marangisto/ProtoCV/pcb.png

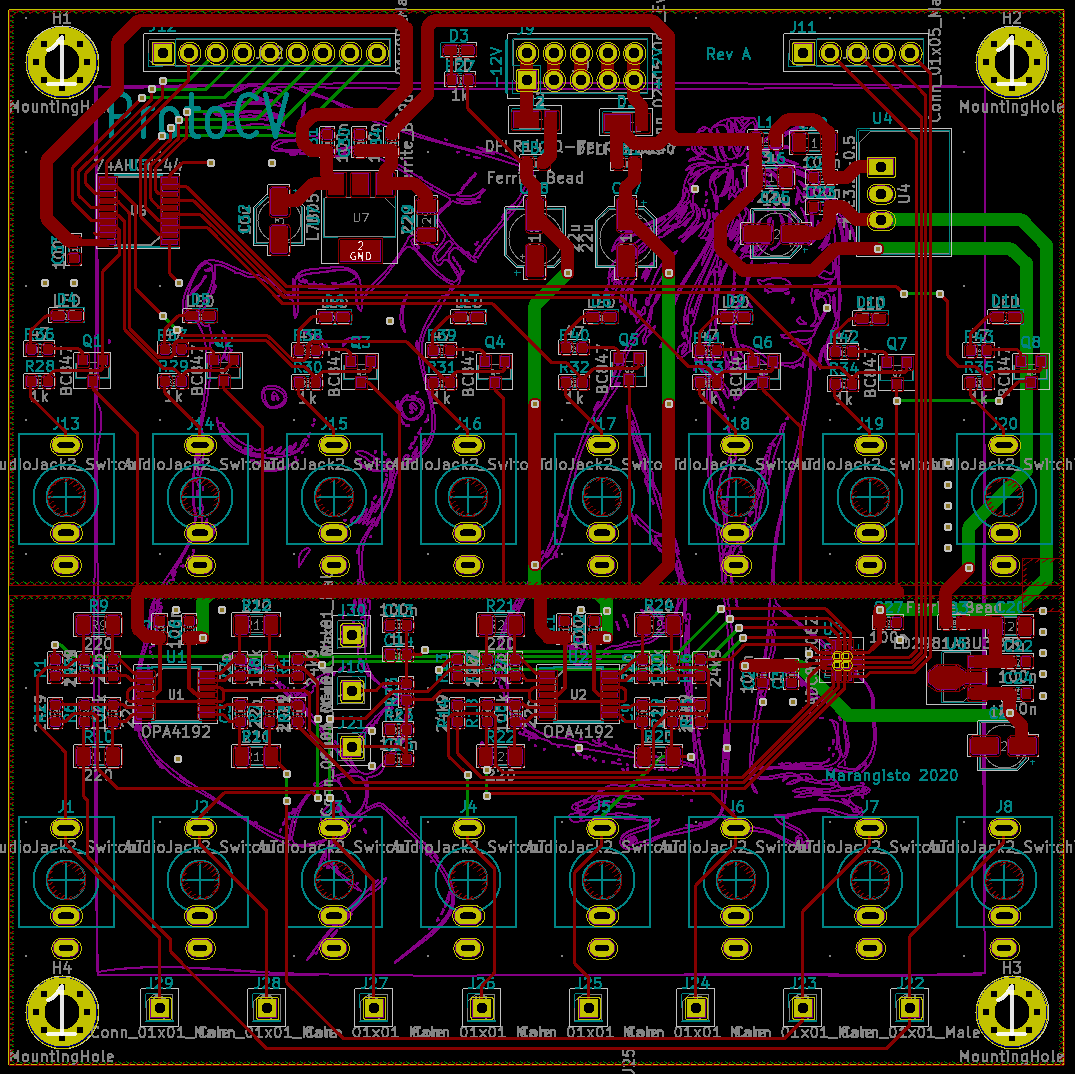
pcb.png
