marangisto/ProtoCV/render-01.png

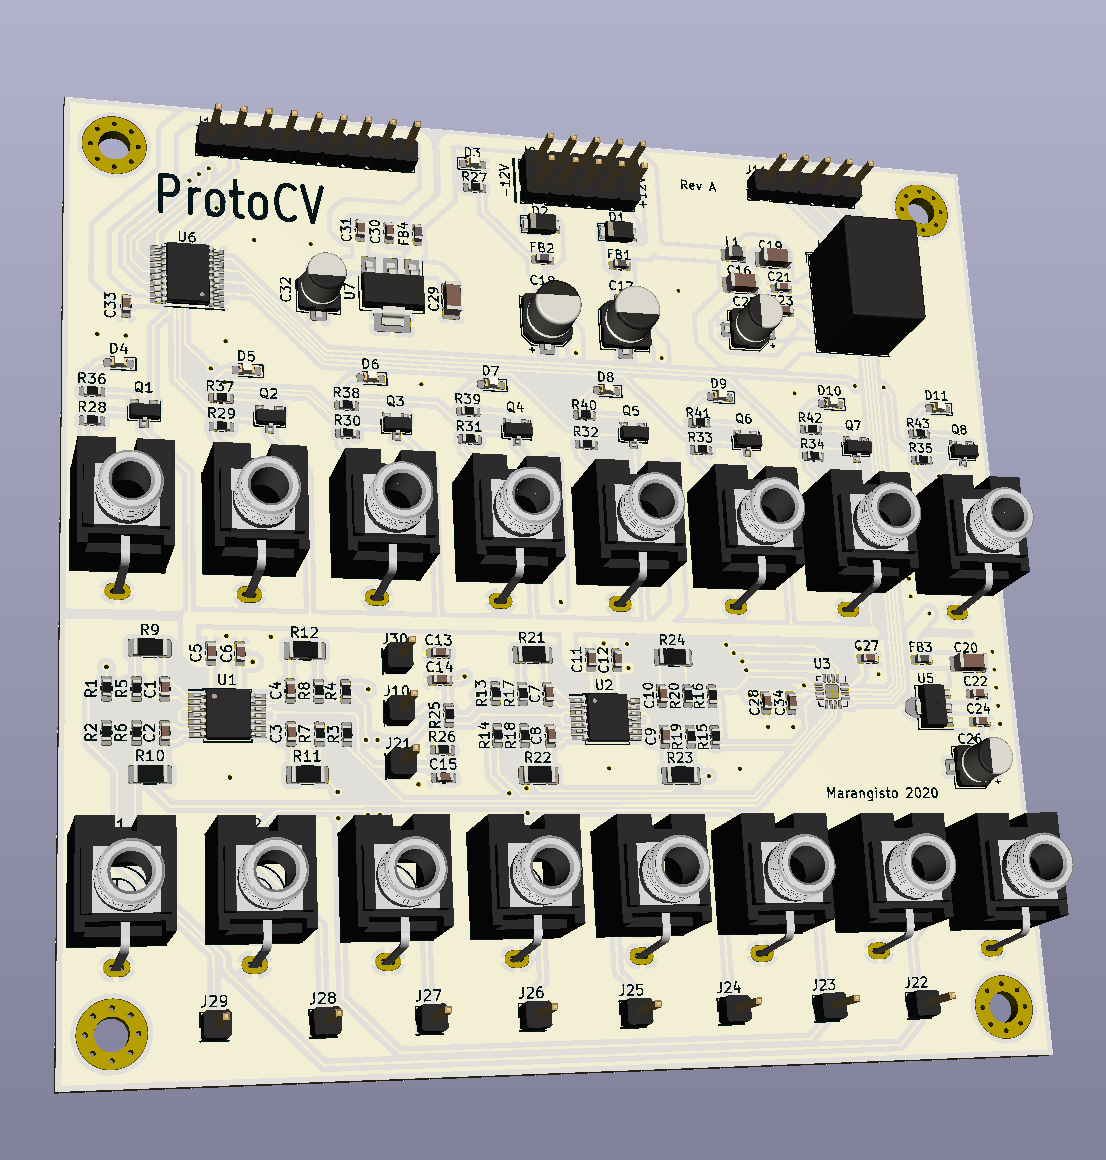
render-01.png
