marangisto/ProtoCV/render-02.png

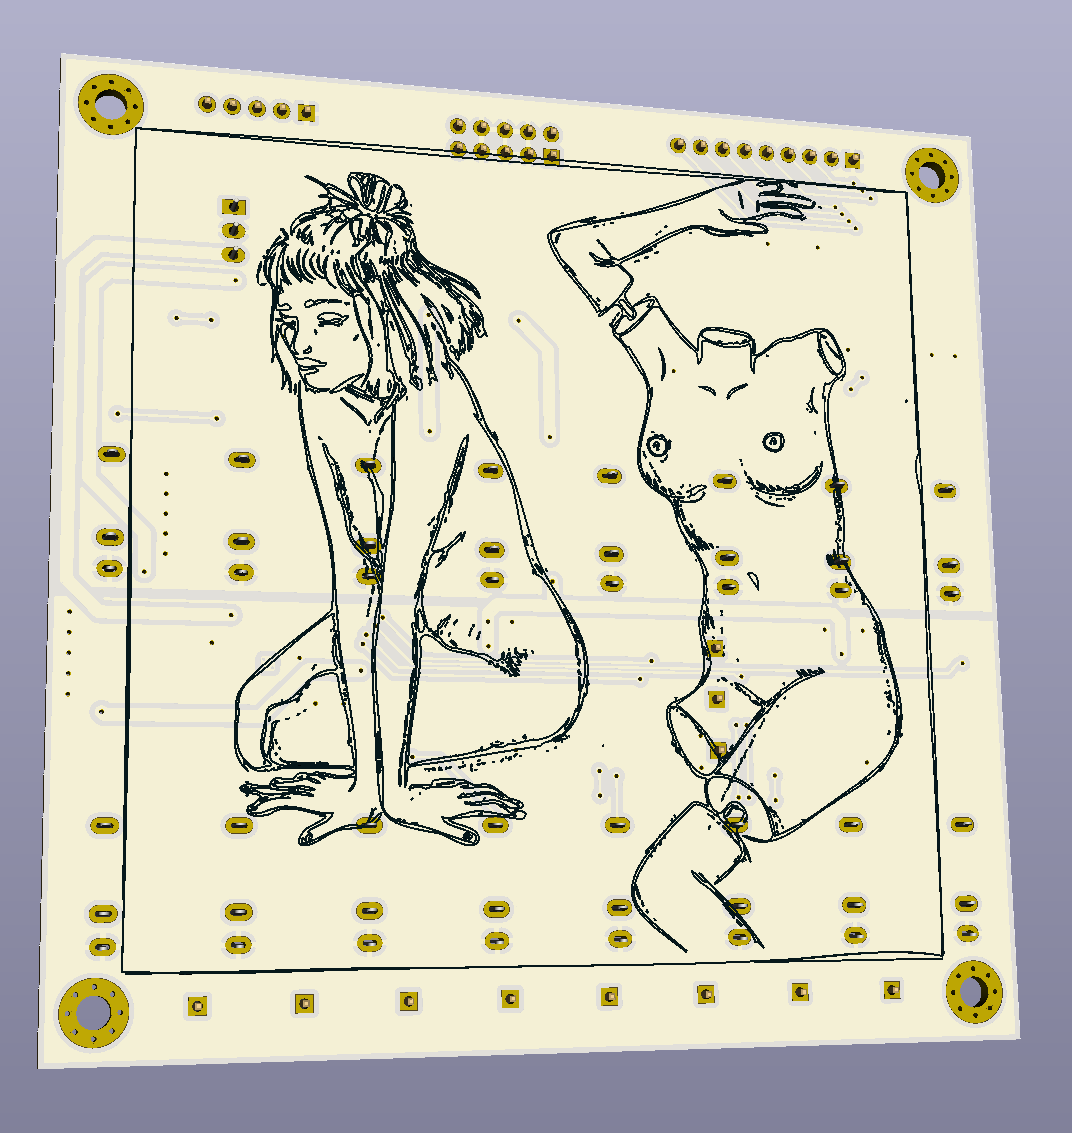
render-02.png
