marangisto/ProtoCV/schematic.png

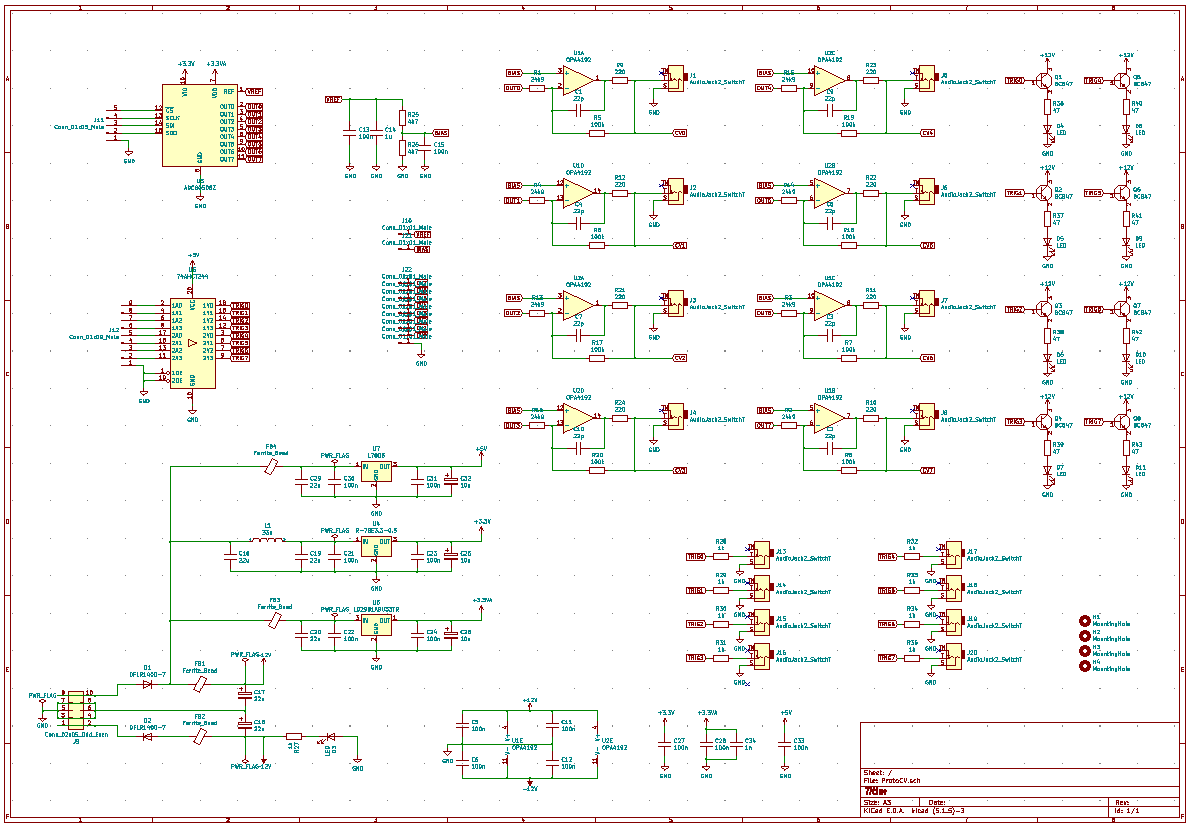
schematic.png
