marangisto/ProtoCV/ProtoCV.pdf

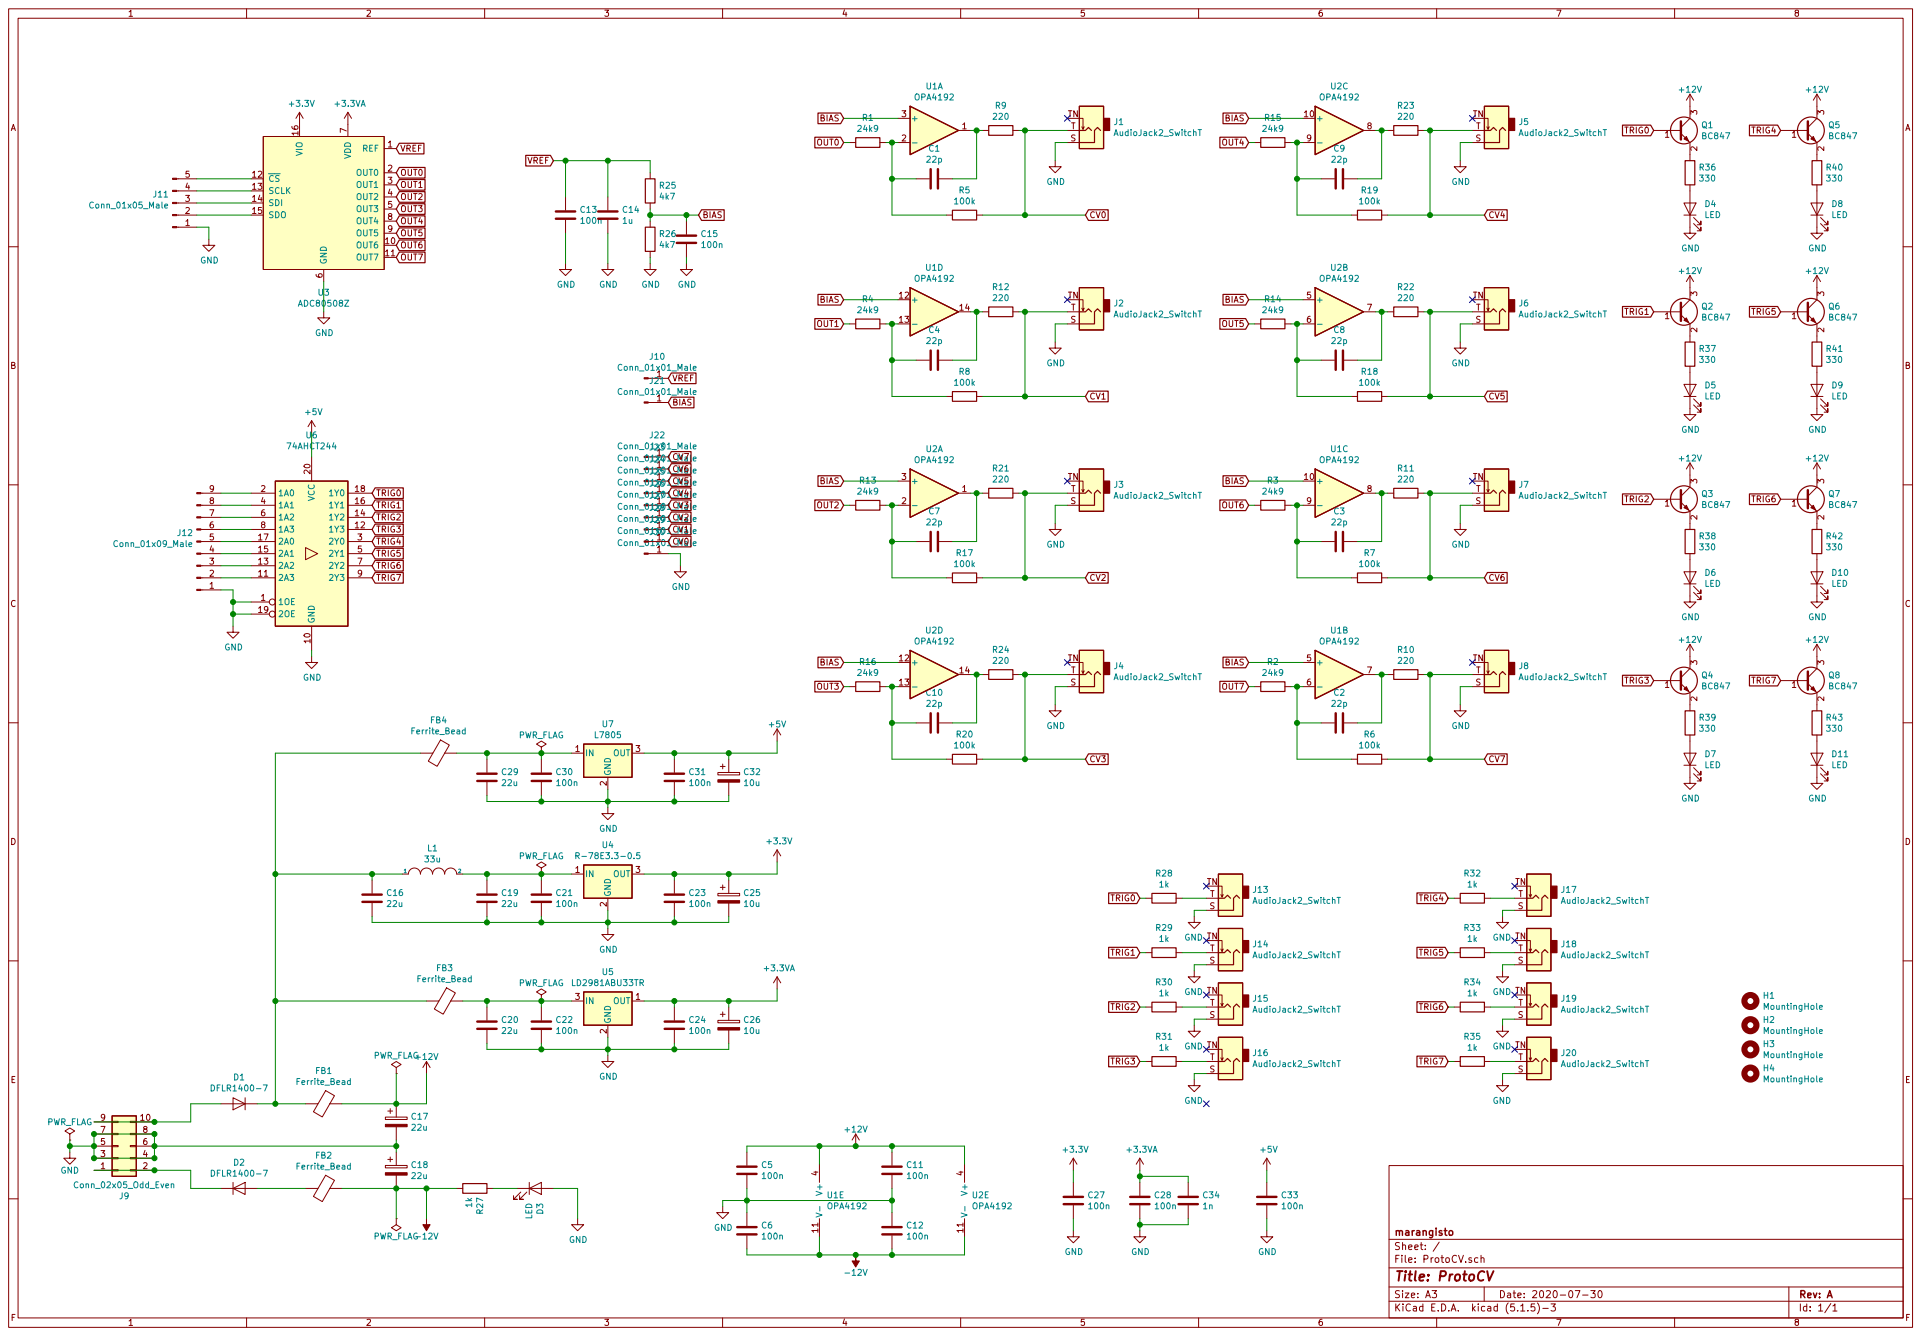
[picture p5: page 1]

5 3 | 6

File: ProtoCV.sch Sheet: / marangisto
