marangisto/ProtoCV/ProtoCV.kicad_pcb

## KiCad design ProtoCV.kicad_pcb (2020-12-03)

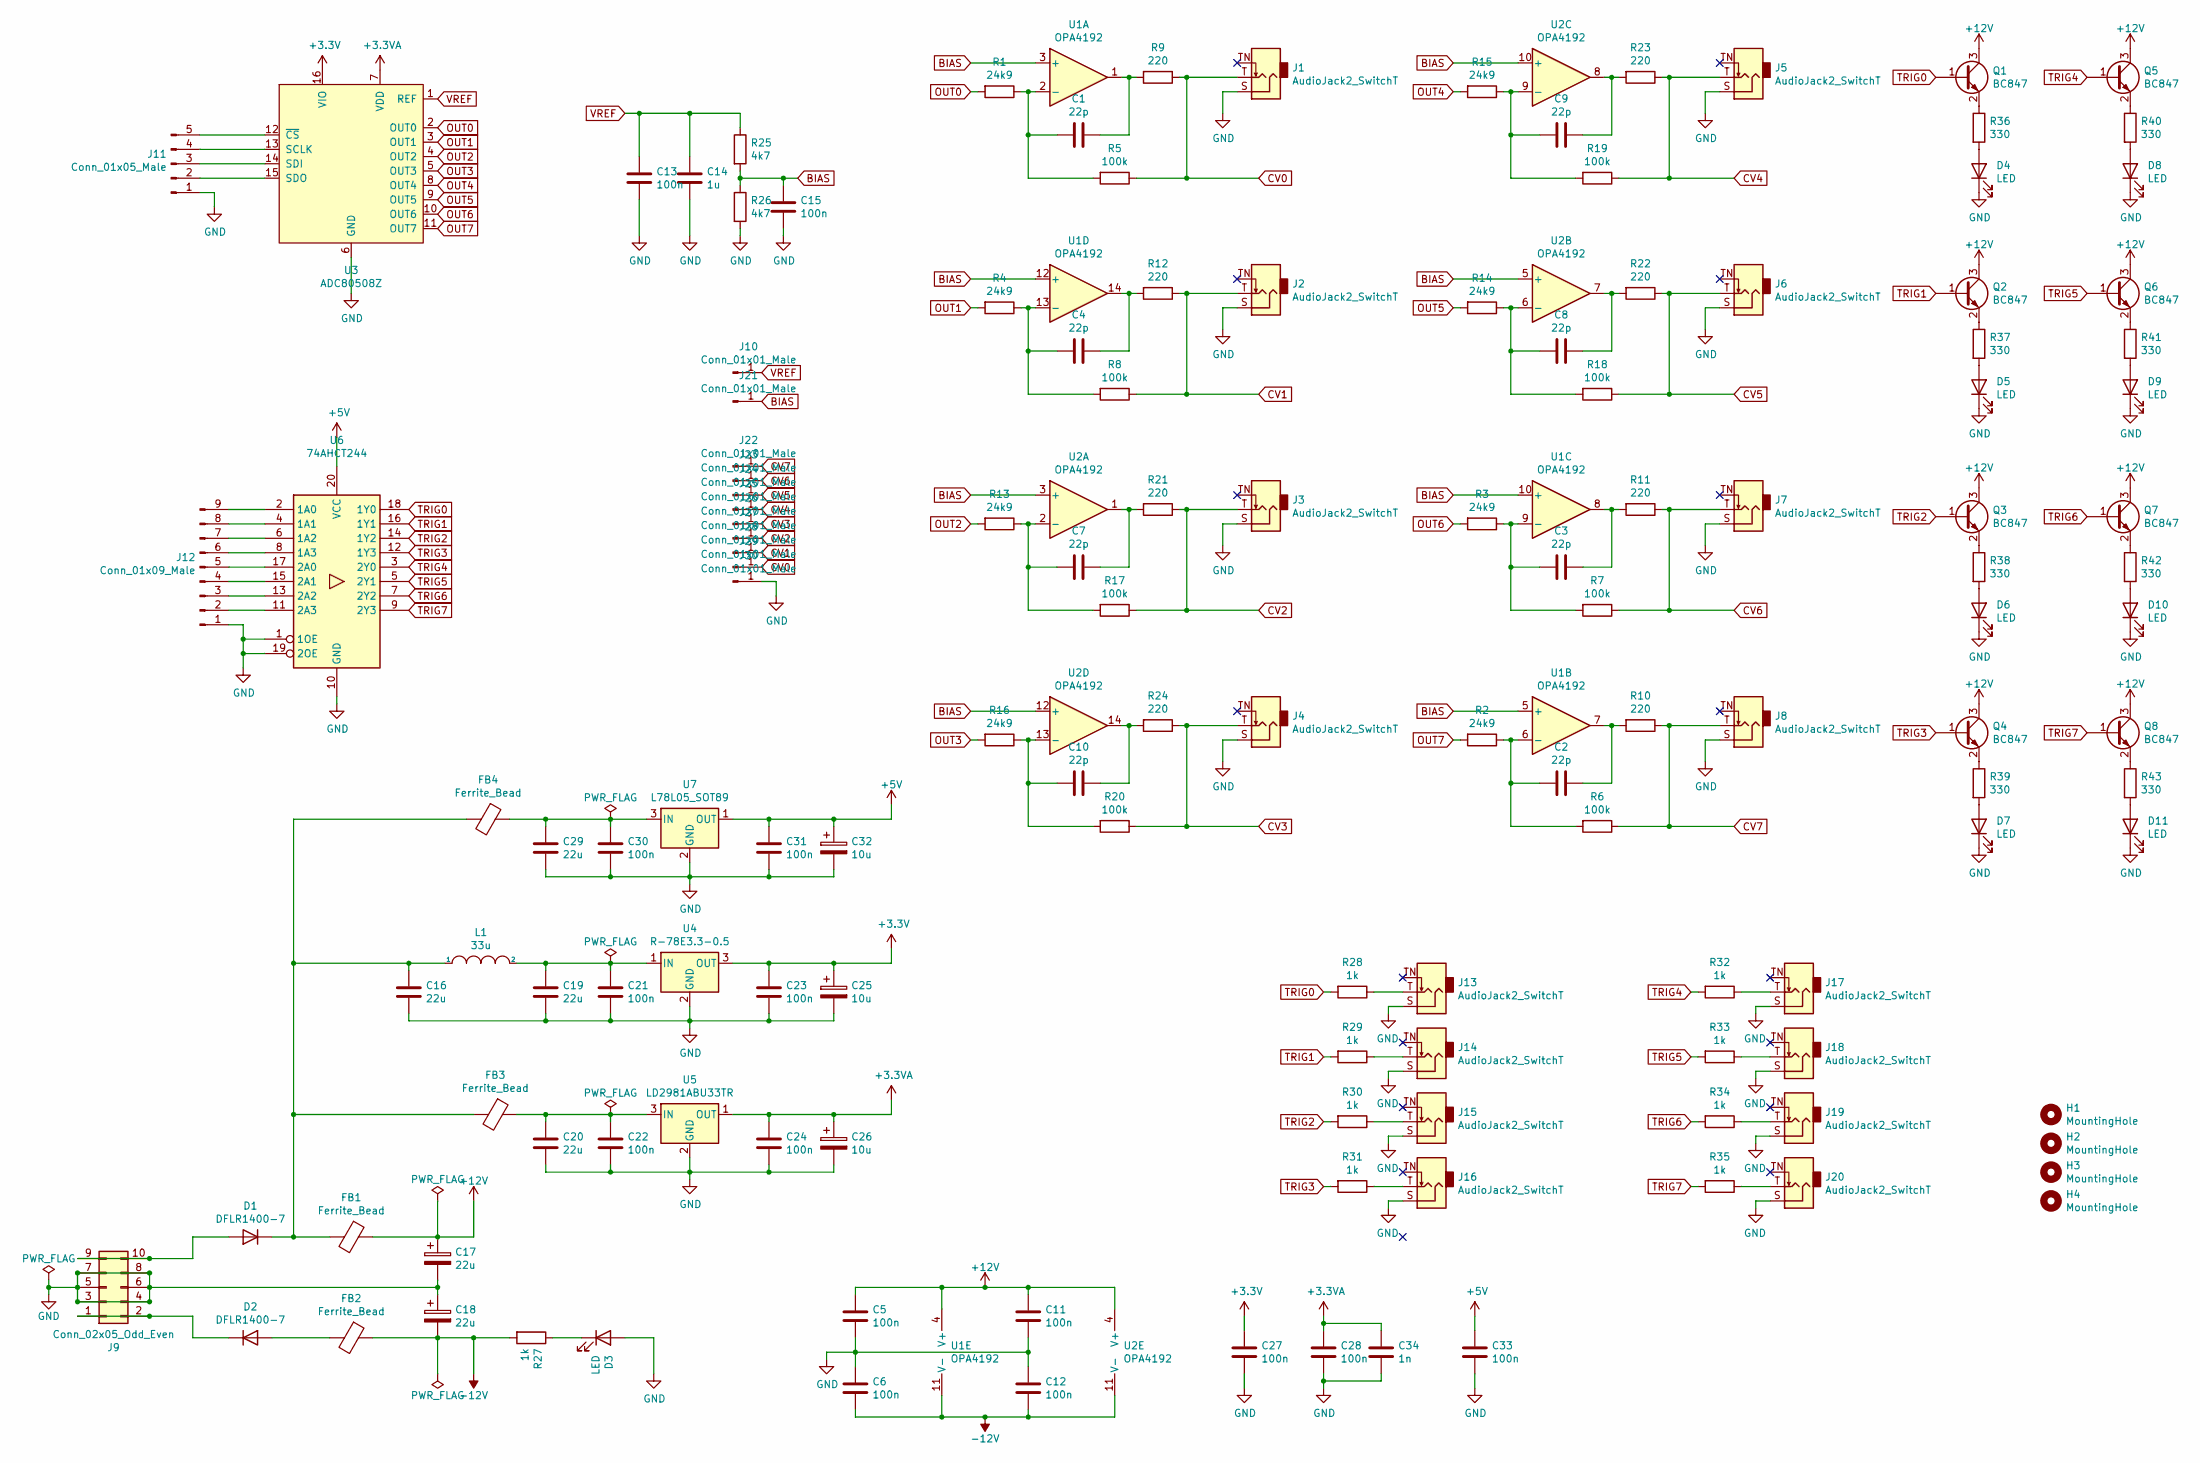
[picture p6: schematic ProtoCV.sch]

Parts:
C1, C2, C3, C4, C7, C8, C9, C10: 22p; C_0603_1608Metric
C5, C6, C11, C12, C13, C15, C21, C22, C23, C24, C27, C28, C30, C31, C33: 100n; C_0603_1608Metric
C14: 1u; C_0603_1608Metric
C16, C19, C20, C29: 22u; C_1206_3216Metric
C17, C18: 22u; CP_Elec_5x5.4
C25, C26, C32: 10u; CP_Elec_4x5.8
C34: 1n; C_0603_1608Metric
D1, D2: DFLR1400-7; D_PowerDI-123
D3, D4, D5, D6, D7, D8, D9, D10, D11: LED; LED_0603_1608Metric_Castellated
FB1, FB2, FB3, FB4: Ferrite_Bead; L_0603_1608Metric
H1, H2, H3, H4: MountingHole; MountingHole_3.2mm_M3_Pad_Via
J1, J2, J3, J4, J5, J6, J7, J8, J13, J14, J15, J16, J17, J18, J19, J20: AudioJack2_SwitchT; PJ398SM
J9: Conn_02x05_Odd_Even; PinHeader_2x05_P2.54mm_Vertical
J10, J21, J22, J23, J24, J25, J26, J27, J28, J29, J30: Conn_01x01_Male; PinHeader_1x01_P2.54mm_Vertical
J11: Conn_01x05_Male; PinHeader_1x05_P2.54mm_Vertical
J12: Conn_01x09_Male; PinHeader_1x09_P2.54mm_Vertical
L1: 33u; L_0805_2012Metric
Q1, Q2, Q3, Q4, Q5, Q6, Q7, Q8: BC847; SOT-23
R1, R2, R3, R4, R13, R14, R15, R16: 24k9; R_0603_1608Metric
R5, R6, R7, R8, R17, R18, R19, R20: 100k; R_0603_1608Metric
R9, R10, R11, R12, R21, R22, R23, R24: 220; R_1206_3216Metric
R25, R26: 4k7; R_0603_1608Metric
R27, R28, R29, R30, R31, R32, R33, R34, R35: 1k; R_0603_1608Metric
R36, R37, R38, R39, R40, R41, R42, R43: 330; R_0603_1608Metric
U1, U2: OPA4192; TSSOP-14_4.4x5mm_P0.65mm
U3: ADC80508Z; QFN-16-1EP_3x3mm_P0.5mm_EP1.45x1.45mm_ThermalVias
U4: R-78E3.3-0.5; Converter_DCDC_RECOM_R-78E-0.5_THT
U5: LD2981ABU33TR; SOT-89-3
U6: 74AHCT244; TSSOP-20_4.4x6.5mm_P0.65mm
U7: L78L05_SOT89; SOT-89-3

Connections:
+3.3VA: C24.1, C26.1, C28.1, C34.1, U3.7 (VDD), U5.1 (OUT)
+3V3: C23.1, C25.1, C27.1, U3.16 (VIO), U4.3 (OUT)
+5V: C31.1, C32.1, C33.1, U6.20 (VCC), U7.1 (OUT)
+12V: C5.1, C11.1, C17.1, FB1.1, Q1.3 (C), Q2.3 (C), Q3.3 (C), Q4.3 (C), Q5.3 (C), Q6.3 (C), Q7.3 (C), Q8.3 (C), U1.4 (V+), U2.4 (V+)
-12V: C6.2, C12.2, C18.2, FB2.1, R27.2, U1.11 (V-), U2.11 (V-)
BIAS: C15.1, J21.1, R25.2, R26.1, U1.3 (+), U1.5 (+), U1.10 (+), U1.12 (+), U2.3 (+), U2.5 (+), U2.10 (+), U2.12 (+)
CV0: J1.T, J29.1, R5.1, R9.1
CV1: J2.T, J28.1, R8.1, R12.1
CV2: J3.T, J27.1, R17.1, R21.1
CV3: J4.T, J26.1, R20.1, R24.1
CV4: J5.T, J25.1, R19.1, R23.1
CV5: J6.T, J24.1, R18.1, R22.1
CV6: J7.T, J23.1, R7.1, R11.1
CV7: J8.T, J22.1, R6.1, R10.1
GND: C5.2, C6.1, C11.2, C12.1, C13.2, C14.2, C15.2, C16.2, C17.2, C18.1, C19.2, C20.2, C21.2, C22.2, C23.2, C24.2, C25.2, C26.2, C27.2, C28.2, C29.2, C30.2, C31.2, C32.2, C33.2, C34.2, D3.2 (A), D4.1 (K), D5.1 (K), D6.1 (K), D7.1 (K), D8.1 (K), D9.1 (K), D10.1 (K), D11.1 (K), J1.S, J2.S, J3.S, J4.S, J5.S, J6.S, J7.S, J8.S, J9.3, J9.4, J9.5, J9.6, J9.7, J9.8, J11.1, J12.1, J13.S, J14.S, J15.S, J16.S, J17.S, J18.S, J19.S, J20.S, J30.1, R26.2, U3.6 (GND), U4.2 (GND), U5.2 (GND), U6.1 (1OE), U6.10 (GND), U6.19 (2OE), U7.2 (GND)
unnamed: C1.1, R9.2, U1.1
unnamed: C1.2, R1.1, R5.2, U1.2 (-)
unnamed: C2.1, R10.2, U1.7
unnamed: C2.2, R2.1, R6.2, U1.6 (-)
unnamed: C3.1, R11.2, U1.8
unnamed: C3.2, R3.1, R7.2, U1.9 (-)
unnamed: C4.1, R12.2, U1.14
unnamed: C4.2, R4.1, R8.2, U1.13 (-)
unnamed: C7.1, R21.2, U2.1
unnamed: C7.2, R13.1, R17.2, U2.2 (-)
unnamed: C8.1, R22.2, U2.7
unnamed: C8.2, R14.1, R18.2, U2.6 (-)
unnamed: C9.1, R23.2, U2.8
unnamed: C9.2, R15.1, R19.2, U2.9 (-)
unnamed: C10.1, R24.2, U2.14
unnamed: C10.2, R16.1, R20.2, U2.13 (-)
unnamed: C16.1, D1.1 (K), FB1.2, FB3.2, FB4.2, L1.1
unnamed: C19.1, C21.1, L1.2, U4.1 (IN)
unnamed: C20.1, C22.1, FB3.1, U5.3 (IN)
unnamed: C29.1, C30.1, FB4.1, U7.3 (IN)
unnamed: D1.2 (A), J9.9, J9.10
unnamed: D2.1 (K), J9.1, J9.2
unnamed: D2.2 (A), FB2.2
unnamed: D3.1 (K), R27.1
unnamed: D4.2 (A), R36.2
unnamed: D5.2 (A), R37.2
unnamed: D6.2 (A), R38.2
unnamed: D7.2 (A), R39.2
unnamed: D8.2 (A), R40.2
unnamed: D9.2 (A), R41.2
unnamed: D10.2 (A), R42.2
unnamed: D11.2 (A), R43.2
unnamed: J11.2, U3.15 (SDO)
unnamed: J11.3, U3.14 (SDI)
unnamed: J11.4, U3.13 (SCLK)
unnamed: J11.5, U3.12 (~CS~)
unnamed: J12.2, U6.11 (2A3)
unnamed: J12.3, U6.13 (2A2)
unnamed: J12.4, U6.15 (2A1)
unnamed: J12.5, U6.17 (2A0)
unnamed: J12.6, U6.8 (1A3)
unnamed: J12.7, U6.6 (1A2)
unnamed: J12.8, U6.4 (1A1)
unnamed: J12.9, U6.2 (1A0)
unnamed: J13.T, R28.1
unnamed: J14.T, R29.1
unnamed: J15.T, R30.1
unnamed: J16.T, R31.1
unnamed: J17.T, R32.1
unnamed: J18.T, R33.1
unnamed: J19.T, R34.1
unnamed: J20.T, R35.1
unnamed: Q1.2 (E), R36.1
unnamed: Q2.2 (E), R37.1
unnamed: Q3.2 (E), R38.1
unnamed: Q4.2 (E), R39.1
unnamed: Q5.2 (E), R40.1
unnamed: Q6.2 (E), R41.1
unnamed: Q7.2 (E), R42.1
unnamed: Q8.2 (E), R43.1
OUT0: R1.2, U3.2 (OUT0)
OUT1: R4.2, U3.3 (OUT1)
OUT2: R13.2, U3.4 (OUT2)
OUT3: R16.2, U3.5 (OUT3)
OUT4: R15.2, U3.8 (OUT4)
OUT5: R14.2, U3.9 (OUT5)
OUT6: R3.2, U3.10 (OUT6)
OUT7: R2.2, U3.11 (OUT7)
TRIG0: Q1.1 (B), R28.2, U6.18 (1Y0)
TRIG1: Q2.1 (B), R29.2, U6.16 (1Y1)
TRIG2: Q3.1 (B), R30.2, U6.14 (1Y2)
TRIG3: Q4.1 (B), R31.2, U6.12 (1Y3)
TRIG4: Q5.1 (B), R32.2, U6.3 (2Y0)
TRIG5: Q6.1 (B), R33.2, U6.5 (2Y1)
TRIG6: Q7.1 (B), R34.2, U6.7 (2Y2)
TRIG7: Q8.1 (B), R35.2, U6.9 (2Y3)
VREF: C13.1, C14.1, J10.1, R25.1, U3.1 (REF)

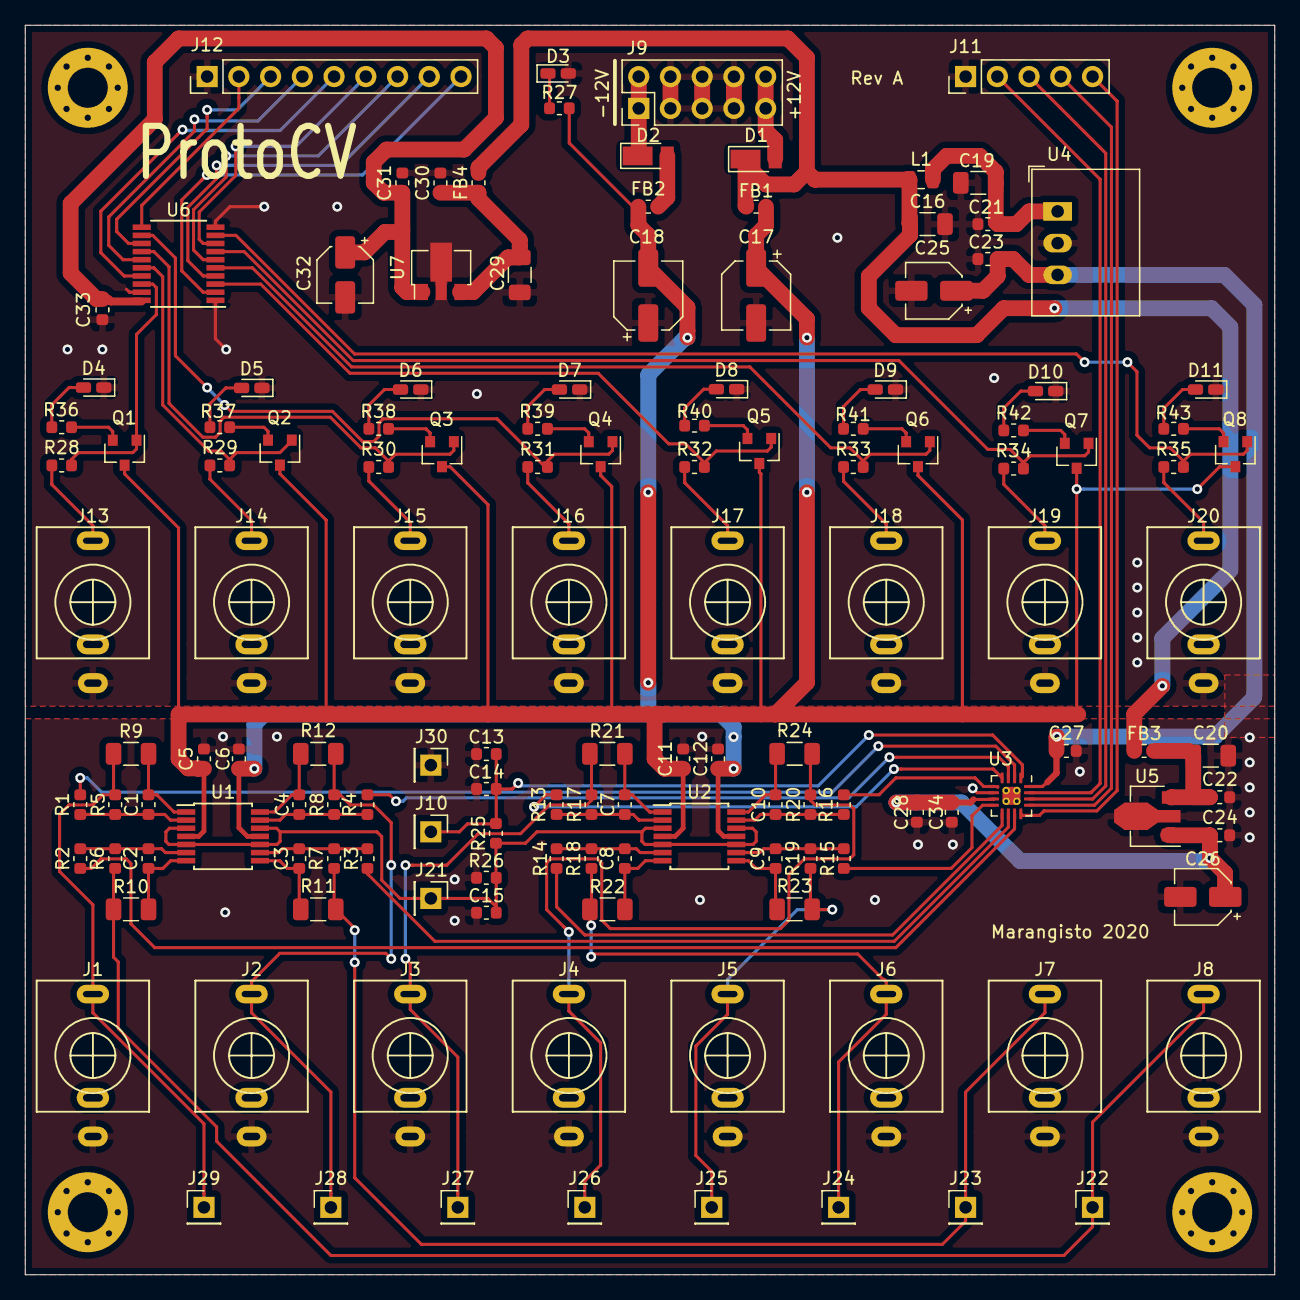
[picture p7: board ProtoCV.kicad_pcb from above]

Board: 2 copper layers, 100.0 x 100.0 mm, 142 parts (0 on the bottom side), 92 nets.
