marangisto/ProtoCV/(commit log)

2020-07-12 Created DAC symbol.
    [POWER.sch, ProtoCV.kicad_pcb, ProtoCV.sch]
2020-07-12 Draft schematic.
    [POWER.sch, ProtoCV.sch]
2020-07-12 Added triggers.
    [ProtoCV.sch]
2020-07-12 Cleaned up ERC.
    [ProtoCV.sch]
2020-07-12 Added leds and drivers.
    [ProtoCV.sch]
2020-07-12 Assigned footprints.
    [ProtoCV.sch]
2020-07-12 Starting placement.
    [ProtoCV.kicad_pcb, ProtoCV.sch]
2020-07-12 Completed placement.
    [ProtoCV.kicad_pcb, ProtoCV.sch]
2020-07-13 Improved placement with separate analogue section.
    [ProtoCV.kicad_pcb, ProtoCV.sch]
2020-07-13 Added keep-outs under jacks.
    [ProtoCV.kicad_pcb]
2020-07-13 Minor layout adjustments.
    [ProtoCV.kicad_pcb]
2020-07-13 Power routing and split ground pour.
    [ProtoCV.kicad_pcb]
2020-07-13 Lots of manual routing.
    [ProtoCV.kicad_pcb, ProtoCV.sch]
2020-07-13 Front side pours.
    [ProtoCV.kicad_pcb]
2020-07-14 Near complete manual routing.
    [ProtoCV.kicad_pcb]
2020-07-14 Completed routing and DRC.
    [ProtoCV.kicad_pcb]
2020-07-14 Front silk-screen.
    [ProtoCV.kicad_pcb]
2020-07-14 Added artwork.
    [ProtoCV.kicad_pcb]
2020-07-14 Generated gerbers.
    [ProtoCV-B_Cu.gbr, ProtoCV-B_Mask.gbr, ProtoCV-B_Paste.gbr, ProtoCV-B_SilkS.gbr, ProtoCV-Edge_Cuts.gbr, ProtoCV-F_Cu.gbr, ProtoCV-F_Mask.gbr, ProtoCV-F_Paste.gbr]
2020-07-28 First working DAC driver code.
2020-07-28 Enabled basic calibration (good to a fifth milli-volt).
2020-07-28 Refactored board setup in separate file.
2020-07-29 Corrected led resistor values.
    [ProtoCV.kicad_pcb, ProtoCV.sch]
2020-07-30 Generated schematic PDF.
    [ProtoCV.sch]
2020-12-03 Corrected footprint for 5V regulator.
    [ProtoCV.kicad_pcb, ProtoCV.sch]
2020-12-03 Regenerated Gerbers.
    [ProtoCV-B_Cu.gbr, ProtoCV-B_Mask.gbr, ProtoCV-B_Paste.gbr, ProtoCV-B_SilkS.gbr, ProtoCV-Edge_Cuts.gbr, ProtoCV-F_Cu.gbr, ProtoCV-F_Mask.gbr, ProtoCV-F_Paste.gbr]
